KyleHagy/Cal-Trans-C1-Reader/PCB & Schematic/vB6.0 - Gerbers and Store Price (1-15-2020)/Sent Files/ReadMe.txt

Kyle Hagy
Caltrans
Division of Research, Innovation and System Information
1727 30th Street, 1st Floor
Sacramento, CA 95816
(916) 227-2681

C1 Reader, Version B6.0

The zip includes the following:
   - Gerber 274X files
   - BOM
   - Parts Centroids
