KyleHagy/Cal-Trans-C1-Reader/PCB & Schematic/C1 Reader PCB Layout/Final Completed PCB (3-30-2020)/Photos/2.png

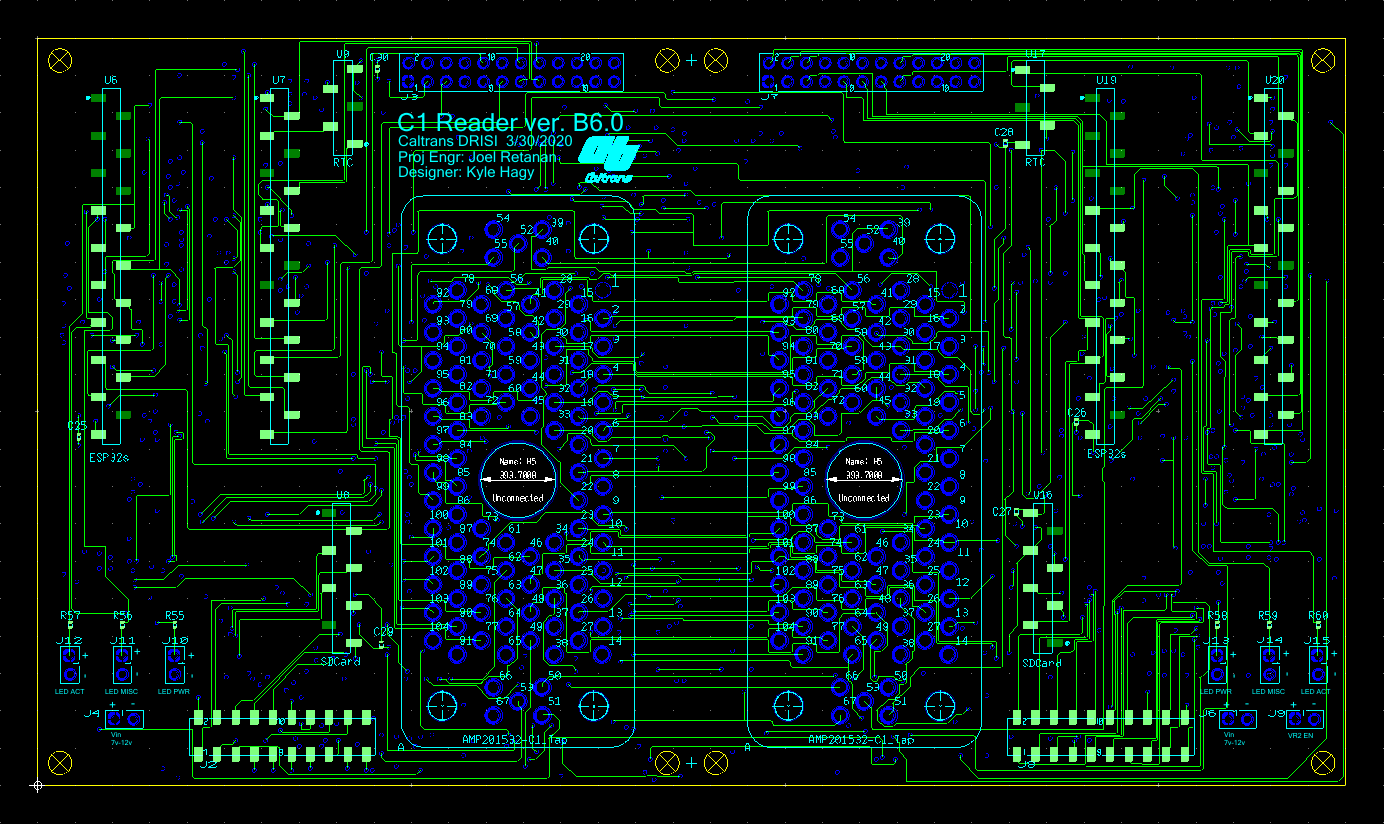
PCB & Schematic/C1 Reader PCB Layout/Final Completed PCB (3-30-2020)/Photos/2.png
