KyleHagy/Cal-Trans-C1-Reader/PCB & Schematic/C1 Reader PCB Layout/Final Completed PCB (3-30-2020)/Gerbers and BOM/ReadMe.txt

Kyle Hagy
Caltrans
Division of Research, Innovation and System Information
1727 30th Street, 1st Floor
Sacramento, CA 95816
(916) 227-2681

C1 Reader, Version B6.0

The zip includes the following:
   - Gerber 274X files
   - BOM
   - Parts Centroids

Other Notes:
   - ROHS		
   - J3 & J7 are through hole 
   - Install D1 & D2 as SMA even though file says S1A
   - There are no 125MIL even though file might say there are
