KyleHagy/Cal-Trans-C1-Reader/PCB & Schematic/vB6.0 - Gerbers and Store Price (1-15-2020)/Sent Files/C1 Reader PCB vB6_0 BOM.xlsx

Quantity | Description | RefDes | Package | Type | Obsolete | Vendor | Status | Price | Hyperlink | Manufacturer | Manufacturer Part No. | Vendor Part No.
2 | SDCard, Adafruit SD Card | U8, U16 | Ultiboard\NPTC081KFXC-RC |  | No | Newark | In Stock |  | https://www.newark.com/samtec/ssm-108-l-sv-lc/connector-receptacle-8-contacts/dp/81P4450?st=SSM-108-L-SV-LC | Samtec Inc. | SSM-108-L-SV-LC | 81P4450
2 | GENERIC, HDR2X12 | J3, J7 | Generic\HDR2X12 |  | No | Digikey | In Stock |  | https://www.digikey.com/product-detail/en/samtec-inc/SSM-112-L-DV-LC/SAM12897-ND/6693778 | Samtec Inc. | SSM-112-L-DV-LC | SAM12897-ND
2 | GENERIC, HDR2X10 | J2, J8 | Ultiboard\HDR2X10(SMT) |  | No | Digikey | In Stock |  | http://www.digikey.com/product-detail/en/NPTC102KFMS-RC/S5680-ND/776139 | Sullins Connector Solutions | NPTC102KFMS-RC | S5680-ND
2 | Arduino, SparkFun Real Time Clock | U9, U17 | Ultiboard\NPPC051KFXC-RC |  | No | Digikey | In Stock |  | https://www.digikey.com/product-detail/en/sullins-connector-solutions/NPPC051KFXC-RC/S5636-ND/776095 | Sullins Connector Solutions | NPPC051KFXC-RC | S5636-ND
2 | LED_SMT_red | LED1, LED4 | Ultiboard\LED_SMT |  | No | Mouser | In Stock |  | http://www.mouser.com/ProductDetail/Lumex/SML-LX0402SIC-TR/?qs=sGAEpiMZZMseGfSY3csMkVGZHPrmcctl3WpasuhDJK4%3d | Lumex | SML-LX0402SIC-TR | 696-SML-LX0402SICTR
12 | RESISTOR, 330Ω | R16, R17, R18, R52, R53, R54, R55, R56, R57, R58, R59, R60 | Generic\0402 |  | No | Digikey | In stock |  | https://www.digikey.com/product-detail/en/yageo/RC0402JR-07330RL/311-330JRTR-ND/726465 | Yageo | RC0402JR-07330RL | 311-330JRTR-ND
2 | LED_SMT_green | LED2, LED5 | Ultiboard\LED_SMT |  | No | Mouser | In Stock |  | http://www.mouser.com/ProductDetail/Lumex/SML-LX0402SUGC-TR/?qs=sGAEpiMZZMseGfSY3csMkVGZHPrmcctlUh1y62qpzDY%3d | Lumex | SML-LX0402SUGC-TR
2 | LED_SMT_blue | LED3, LED6 | Ultiboard\LED_SMT |  | No | Mouser | In Stock |  | http://www.mouser.com/ProductDetail/Vishay-Semiconductors/VLMB1500-GS08/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 | Vishay Semiconductors | VLMB1500-GS08 | 78-VLMB1500-GS08
2 | Arduino, ESP32s Left Side | U6, U19 | Ultiboard\NPTC191KFXC-RC |  | No | Newark | In stock |  | https://www.newark.com/samtec/ssm-119-l-sv-lc/connector-receptacle-19-contacts/dp/81P6399 | Samtec Inc. | SSM-119-L-SV-LC | 81P6399
2 | Arduino, ESP32s Right Side | U7, U20 | Ultiboard\NPTC191KFXC-RC |  | No | Newark | In stock |  | https://www.newark.com/samtec/ssm-119-l-sv-lc/connector-receptacle-19-contacts/dp/81P6399 | Samtec Inc. | SSM-119-L-SV-LC | 81P6399
26 | CAPACITOR, 0.01µF | C1, C2, C3, C4, C5, C6, C7, C8, C9, C10, C13, C14, C15, C16, C17, C18, C19, C20, C21, C22, C25, C26, C27, C28, C29, C30 | Generic\0402 |  | No | Digikey | In Stock |  | http://www.digikey.com/product-detail/en/CC0402KRX7R9BB103/311-1349-1-ND/2103133 | Yageo | CC0402KRX7R9BB103 | 311-1349-1-ND
1 | DIODE, S1A | D1, D2 | Generic\DO-214AC |  | No | Digikey | In Stock |  | http://www.digikey.com/product-detail/en/S1A-13-F/S1A-FDITR-ND/749977 | Diodes Incorporated | S1A-13-F | S1A-FDITR-ND
2 | LM2940IMP-5.0/NOPB | U10, U18 | Generic\SOT-223 |  | No | Digikey | In Stock |  | https://www.digikey.com/product-detail/en/texas-instruments/LM2940IMP-5.0-NOPB/LM2940IMP-5.0-NOPBCT-ND/270744 | Texas Instruments | LM2940IMP-5.0/NOPB | LM2940IMP-5.0/NOPBCT-ND
2 | CAPACITOR, 22µF | C12, C23 | Generic\0402 |  | No | Digikey | In Stock |  | https://www.digikey.com/product-detail/en/yageo/CC1206ZKY5V5BB226/311-3461-1-ND/7164482 | Yageo | CC1206ZKY5V5BB226 | 311-3461-1-ND
2 | CAPACITOR, 0.47µF | C11, C24 | Generic\0402 |  | No | Digikey | In Stock |  | https://www.digikey.com/product-detail/en/yageo/CC0201MRX5R4BB474/311-3320-1-ND/6818290 | Yageo | CC0201MRX5R4BB474 | 311-3320-1-ND
10 | AUTOMOTIVE, MAX13362 | U1, U2, U3, U4, U5, U11, U12, U13, U14, U15 | Ultiboard\MAX13362 |  | No | Digikey | In Stock |  | https://www.digikey.com/product-detail/en/maxim-integrated/MAX13362ATL-V/MAX13362ATL-V-ND/2061996 | Maxim Integrated | MAX13362ATL/V+ | MAX13362ATL/V+-ND
48 | RESISTOR, 100Ω | R1, R2, R3, R4, R5, R6, R7, R8, R9, R10, R11, R12, R13, R14, R15, R19, R20, R21, R22, R23, R24, R25, R26, R27, R28, R29, R30, R31, R32, R33, R34, R35, R36, R37, R38, R39, R40, R41, R42, R43, R44, R45, R46, R47, R48, R49, R50, R51 | Generic\0402 |  | No | Digikey | In Stock |  | http://www.digikey.com/product-detail/en/RC0402FR-07100RL/311-100LRCT-ND/729474 | Yageo | RC0402FR-07100RL | 311-100LRCT-ND
