KyleHagy/Cal-Trans-C1-Reader/PCB & Schematic/vB6.0 - Gerbers and Store Price (1-15-2020)/Revised Quote C1 Reader PCB vB6_0-RFQ-SHEET (2).xls

Sheet: Quote Sheet
Address: 2149-20 O’Toole Ave. San Jose Ca 95131 408-496-6013. |  |  | Order # : |  |  | E-mail Id : |  |  |  | Customer details: KYLE HAGY Kyle.Hagy@dot.ca.gov Division of Research, Innovation and Systems Information Ph: (916)227-7679
 |  |  | Quote # : | 273275 |  | Tel:
 |  |  | Sales Person: |  |  | Date: |  |  | 2020-01-29
Customer PO: |  | Cust Ref: |  |  | Board Size: | 7.000" | x | 4.000"
Part #: | C1 Reader PCB vB6_0 | Rev: |  |  | Panel Size: | NA | X | NA | Boards/Panel: | NA
Contact: | KYLE HAGY | Layers: | 4-LAYERS |  | Routing: | INDIVIDUAL |  |  | Other info:
Thickness: | 0.062" +/-10% | Finish Type: | ENIG |  | Repeat Order: |  |  |  | IPC CLASS | IPC CLASS-II
Material: | FR-4 | Mask Type: | SMOBC, LPI |  | Silk Top: | WHITE | RoHs: |  | NA | GldFinger: | NA
Hole Count: | 1180 | Mask Top: | BLACK |  | Silk Bottom: | WHITE | DiElect: |  | NA | Edgeplt: | NA
Tool Count: | 8 | Mask Botom: | BLACK |  | Smt sides: | BOTH | ImpCntl: |  | NA | CrbnInk: | NA
Hole Size: | 11.8 MIL | OutFin.Copper Wt: | 1 Oz |  | Smt Pitch: | 19.7 MIL | CntSink: |  | NA | FilledVia: | NA
Line width: | 3.9 MIL | InFin.Copper Wt: | 1 Oz |  | Smt Pads: | 746 | CntBore: |  | NA | MaskTented: | NA
Line space: | 3.9 MIL | Cutout/Slots: | NA |  | Testing: | YES | BBURIE: |  | NA | Drill to Copper | > 7.8 MIL
 | Quantity | Lead Time / Working Days | Unit Price ($) | Extension ($) |  | Snapshots for any design criticality
1 | 15 | 15-18 days Total Lead Time | Lot | $3265.00
2
3
4
5
6
7
8
10 | QUOTE INCLUDES PARTS,
11 | PCB & ASSY LABOR.
12
13
Tooling $ : | N/A | Testing $ : | N/A | Setup $: |  | N/A |  | Stencil $ : | N/A | Program $ : | N/A
Special Remark: |  |  | QUOTED LEAD TIME IS IN BUSINESS DAYS ONLY EXCLUDING WEEKENDS AND HOLIDAYS.
Please call or email if you have any questios. |  |  | 1) Quoted With FR-4, 0.062" +/-10% Thick, 1-Oz copper all layers, ENIG due to tight SMT pitch, please confirm.
Thanks
Roy.

Sheet: Assembly
SL NO | DETAILS | QUANTITY
1 | TOTAL COMPONENT TYPE | 17
2 | TOTAL NUMBERS OF COMPONENTS | 121
3 | PTH COMPONENTS | 13
4 | FINE PITCH ICS | 0
5 | QFN PER BOARD | 10
6 | BGAS PER BOARD | 0
7 | STD SMDS | 98
8 | ASSY SIDE | BOTH
9 | MIN SMD PITCH | 19.7 MIL
10 | LARGE DEVISES PER BOARD
11 | 0201 PACKAGE USED OR NOT | NO
12 | 0402 PACKAGE USED OR NOT | YES
13 | FLEX OR RIGID-FLEX | NO
14 | NO.OF PRESS-FIT OR MODULE PER BOARD | NO
15 | CONFORMAL COATING | NO
16 | CLASS 3 OR ITAR | NO
