KyleHagy/Cal-Trans-C1-Reader/PCB & Schematic/vB6.0 - Gerbers and Store Price (1-15-2020)/Fixes/Tool #452552 PN-C1 Reader PCB vB6_0-EQ.docx

Part #C1 Reader PCB vB6_0-EQ

EQ1: We found single traces in the inner layers and outer copper layers. Please confirm if we need to proceed as per the Gerber data.

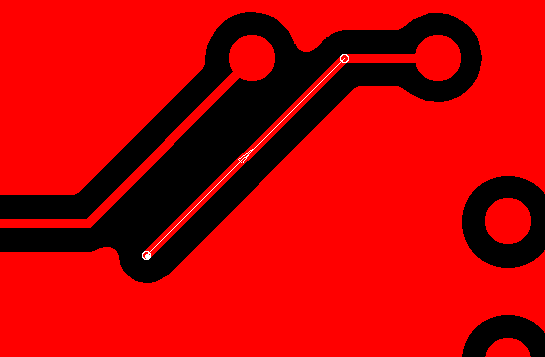
[picture p9: figure]

-> Copper Inner 2

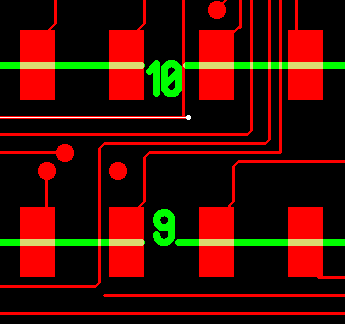
[picture p10: figure]
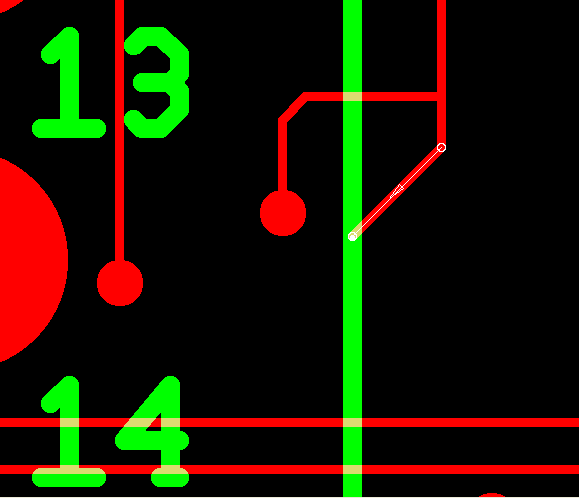
[picture p11: figure]

-> top layer

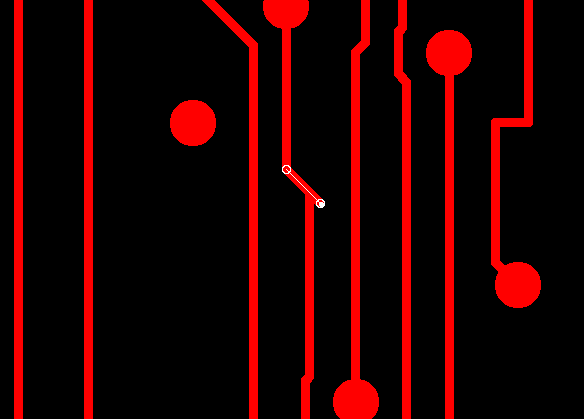
[picture p12: figure]

-> bottom layer

EQ2: There is no copper pads present for the 125mil drills but it is mentioned as PTH drill so please confirm if we can proceed as NPTH drills?
