KyleHagy/Cal-Trans-C1-Reader/PCB & Schematic/C1 Reader Schematic Design/C1 Reader vB6.0 Schematic.pdf

J1

# AMP201532-C1_Tap ¹²³⁴⁵⁶⁷⁸⁹

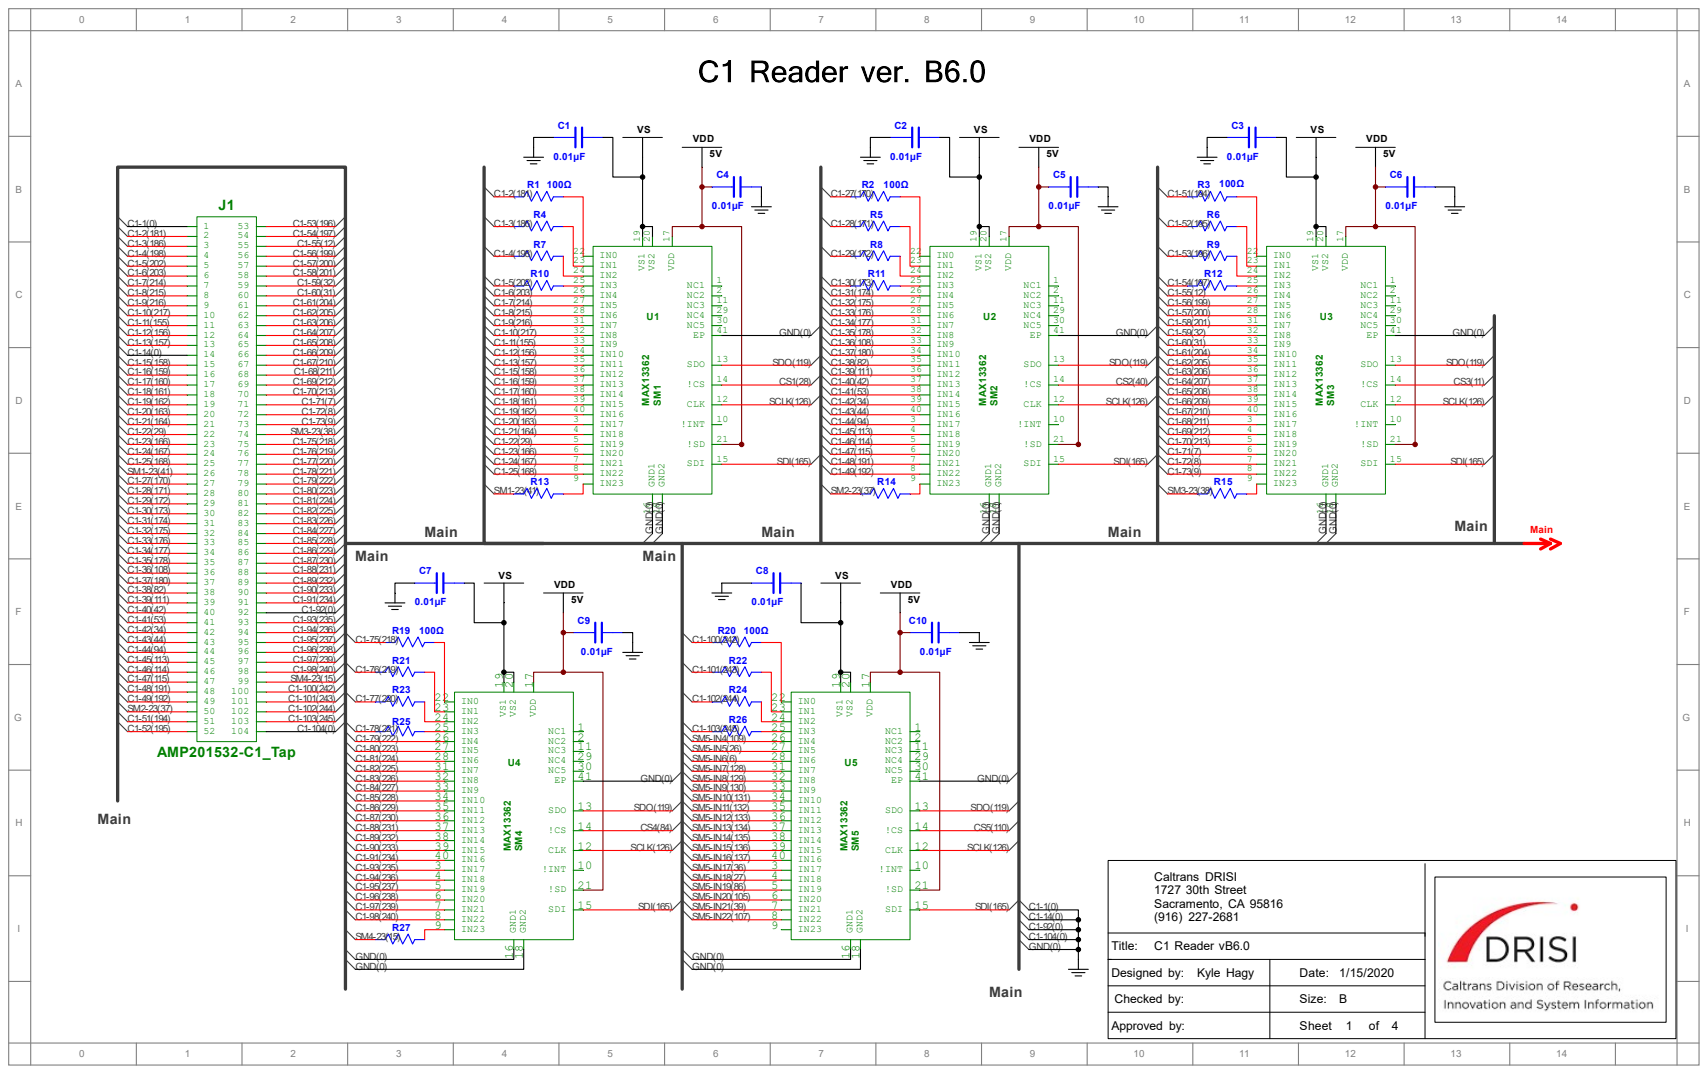
[picture p13: page 1]

U6

## ESP32s Left Side

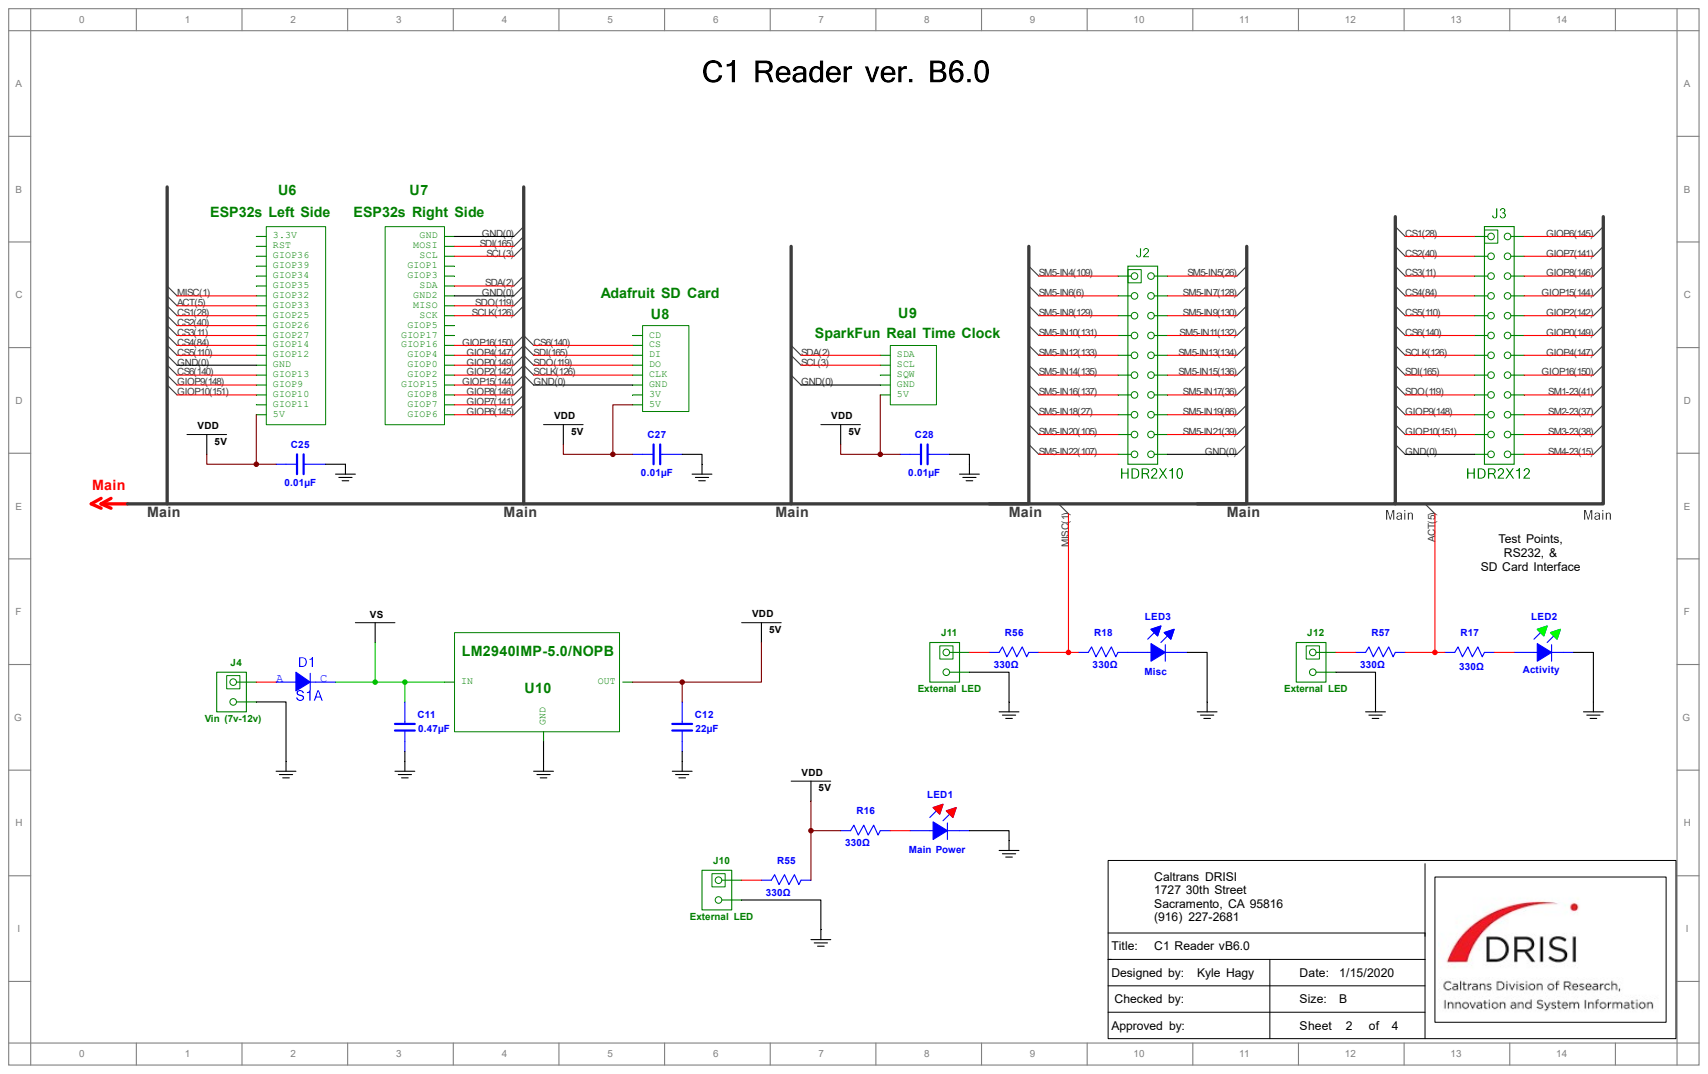
[picture p14: page 2]

SparkFun Real Time Clock

J5

# AMP201532-C1_Tap ¹²³⁴⁵⁶⁷⁸⁹

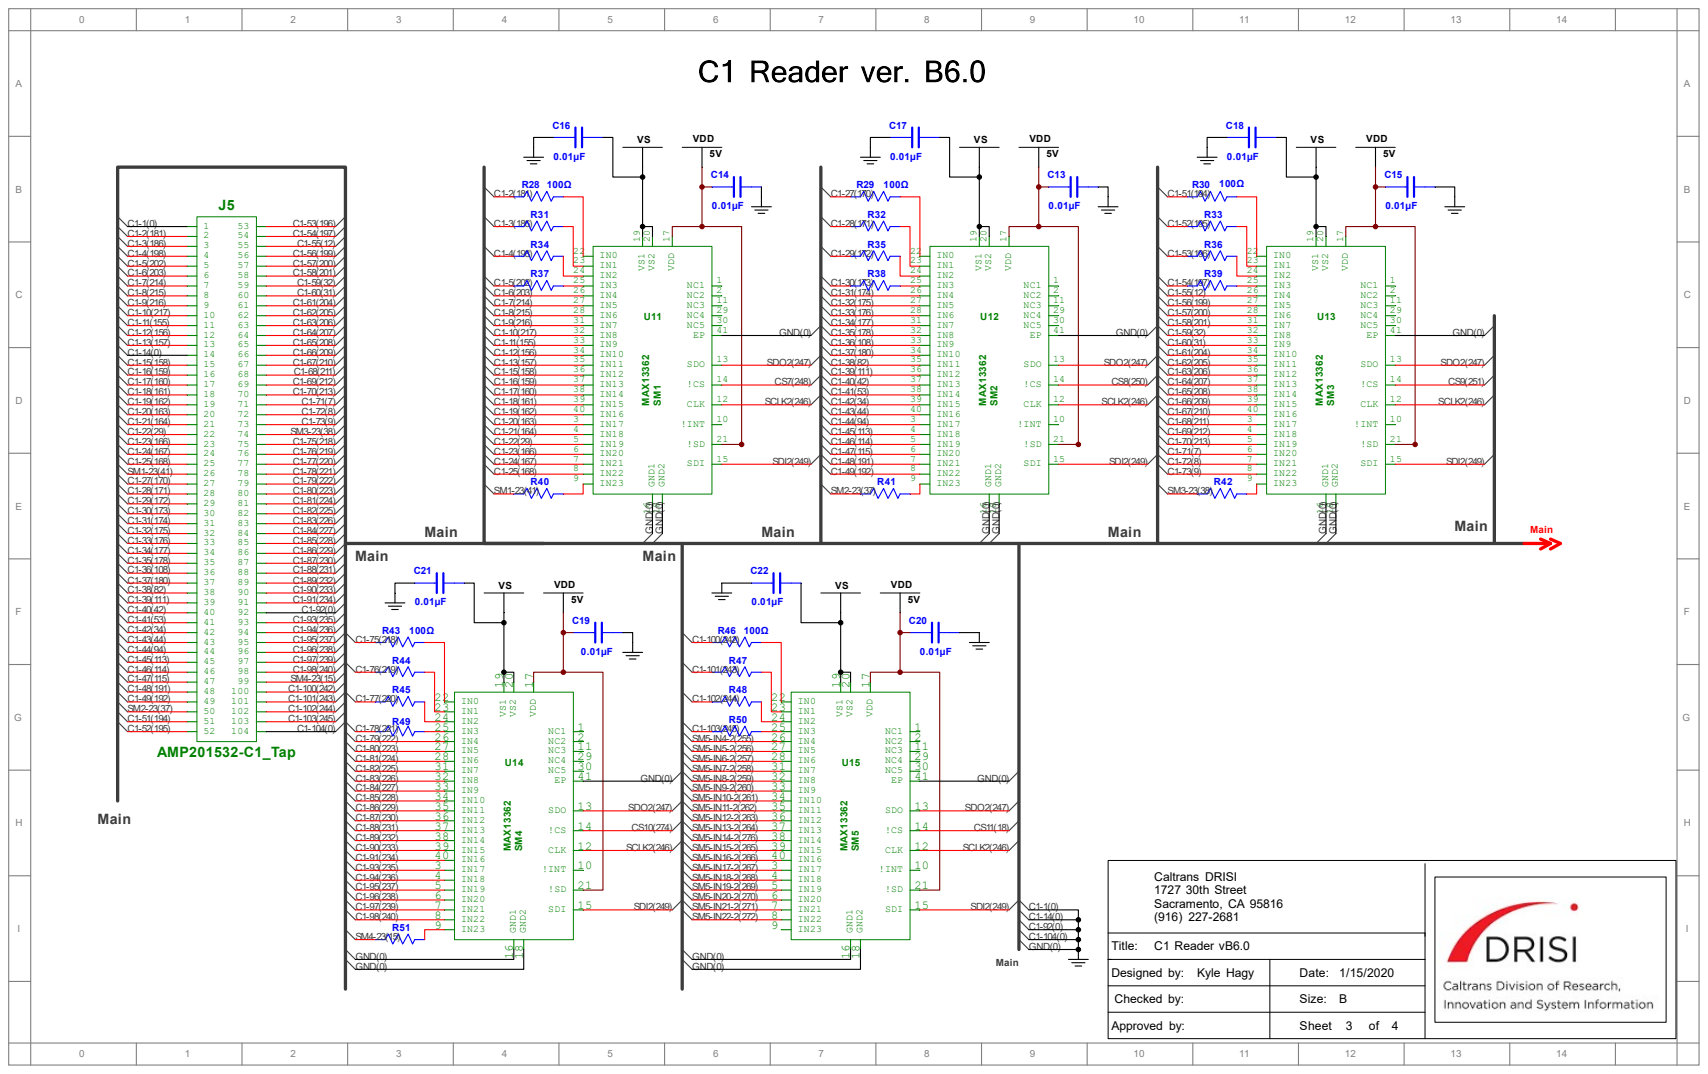
[picture p15: page 3]

U19

## ESP32s Left Side

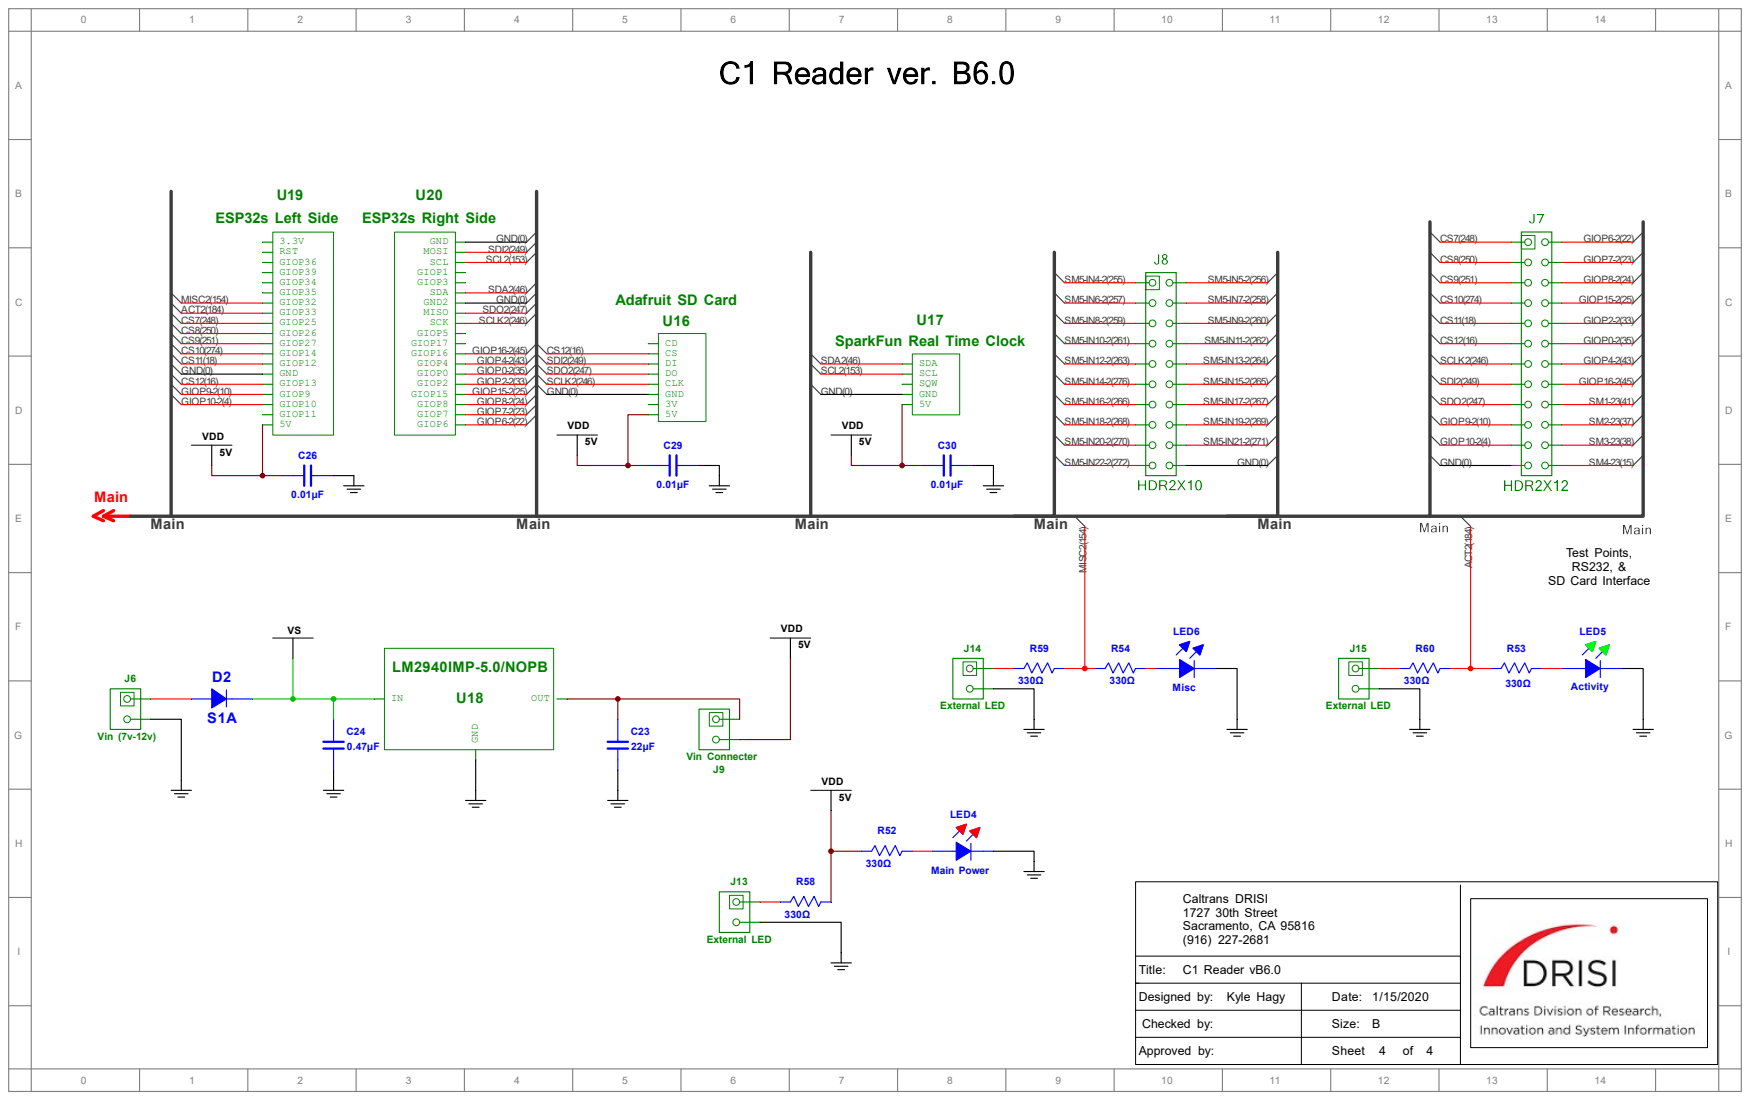
[picture p16: page 4]

SparkFun Real Time Clock
