KyleHagy/Cal-Trans-C1-Reader/(list of files, drawings)

Other design files:
PCB & Schematic/C1 Reader PCB Layout/Past Versions/v0.5 - Back Up/New C1 Reader Schematics x2/New C1 Reader Schematic x2.ms14
PCB & Schematic/C1 Reader Schematic Design/C1 Reader Schematic vB6.0.ms14
